Nazrax/DreamMaskV4/Lucid Scribe Data Converter/README.md

Lucid Scribe Data Converter
======================

Converts to the Lucid Scribe Data format.

<a href="http://lucid-code.com/LucidScribe/DreamMaskV4.Covnerter.zip">Download Converter</a> (Requires <a href="http://lucidcode.com/LucidScribe">Lucid Scribe</a>)

60 seconds of deep sleep: <br />

60 seconds with eye movements: <br />
