Nazrax/DreamMaskV4/eagle/combo - no usb - pth - tcrt5000.brd

## EAGLE design eagle/combo - no usb - pth - tcrt5000.brd (2014-03-25)

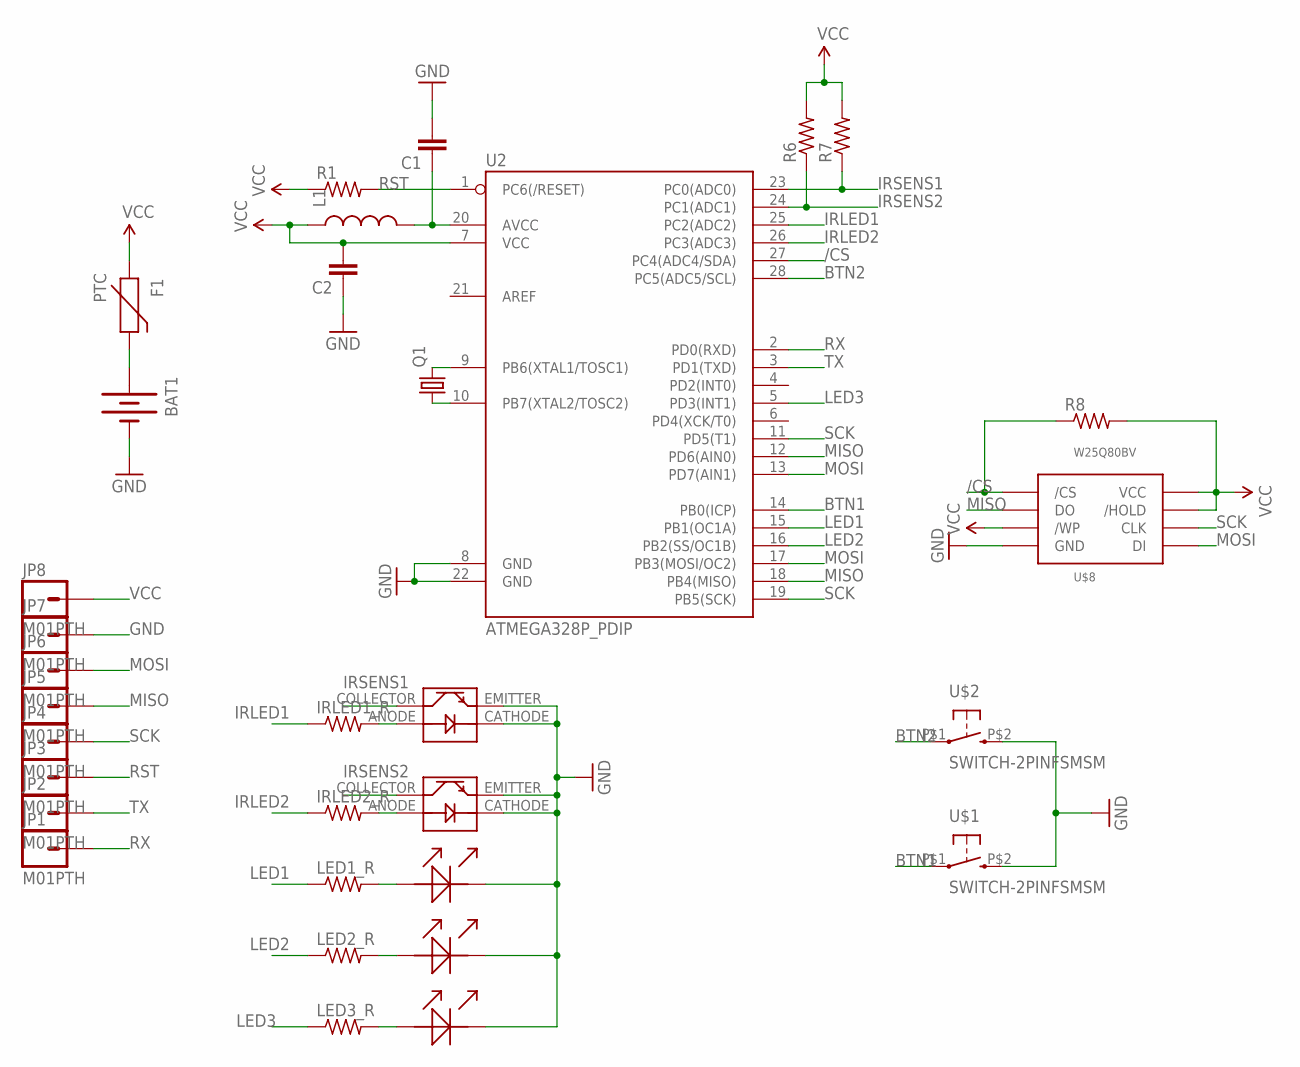
[picture p1: schematic combo - no usb - pth - tcrt5000.sch]

Parts:
BAT1: BATTERYBA2032SM; BA2032SM
C1, C2: CAP0805; 0805
F1: PTC; R0805
IRLED1_R, IRLED2_R: R-US_M0805; M0805
JP1, JP2, JP3, JP4, JP5, JP6, JP7, JP8: M01PTH; 1X01
L1: INDUCTOR0805; 0805
LED1_R, LED2_R, LED3_R: R-US_M0805; M0805
Q1: CRYSTALTC26V; TC26V
R1, R6, R7, R8: R-US_M0805; M0805
U2: ATMEGA328P_PDIP; DIL28-3
U$1, U$2: SWITCH-2PINFSMSM; FSMSM-BUTTON
U$3, U$4: IR_SENSORTCRT5000; TCRT5000
U$5, U$6: LEDPTH; LED
U$7: LED0603; 0603
U$8: W25Q80BVSOIC-08; W25Q80BV-SOIC-208MIL

Connections:
/CS: R8.1, U2.27 (PC4(ADC4/SDA)), U$8./CS
BTN1: U2.14 (PB0(ICP)), U$1.P$1 (1)
BTN2: U2.28 (PC5(ADC5/SCL)), U$2.P$1 (1)
GND: BAT1.-, C1.2, C2.1, JP7.1, U2.8 (GND), U2.22 (GND), U$1.P$2 (3), U$2.P$2 (3), U$3.CATHODE (LED-), U$3.EMITTER, U$4.CATHODE (LED-), U$4.EMITTER, U$5.-, U$6.-, U$7.2 (-), U$8.GND
IRLED1: IRLED1_R.1, U2.25 (PC2(ADC2))
IRLED2: IRLED2_R.1, U2.26 (PC3(ADC3))
IRSENS1: R7.1, U2.23 (PC0(ADC0)), U$3.COLLECTOR
IRSENS2: R6.1, U2.24 (PC1(ADC1)), U$4.COLLECTOR
LED1: LED1_R.1, U2.15 (PB1(OC1A))
LED2: LED2_R.1, U2.16 (PB2(SS/OC1B))
LED3: LED3_R.1, U2.5 (PD3(INT1))
MISO: JP5.1, U2.12 (PD6(AIN0)), U2.18 (PB4(MISO)), U$8.DO
MOSI: JP6.1, U2.13 (PD7(AIN1)), U2.17 (PB3(MOSI/OC2)), U$8.DI
unnamed: BAT1.+, F1.2
unnamed: Q1.2, U2.9 (PB6(XTAL1/TOSC1))
unnamed: Q1.1, U2.10 (PB7(XTAL2/TOSC2))
unnamed: C1.1, L1.2, U2.20 (AVCC)
unnamed: LED3_R.2, U$7.1 (+)
unnamed: LED2_R.2, U$6.+
unnamed: LED1_R.2, U$5.+
unnamed: IRLED2_R.2, U$4.ANODE (LED+)
unnamed: IRLED1_R.2, U$3.ANODE (LED+)
RST: JP3.1, R1.2, U2.1 (PC6(/RESET))
RX: JP1.1, U2.2 (PD0(RXD))
SCK: JP4.1, U2.11 (PD5(T1)), U2.19 (PB5(SCK)), U$8.CLK
TX: JP2.1, U2.3 (PD1(TXD))
VCC: C2.2, F1.1, JP8.1, L1.1, R1.1, R6.2, R7.2, R8.2, U2.7 (VCC), U$8./HOLD, U$8./WP, U$8.VCC

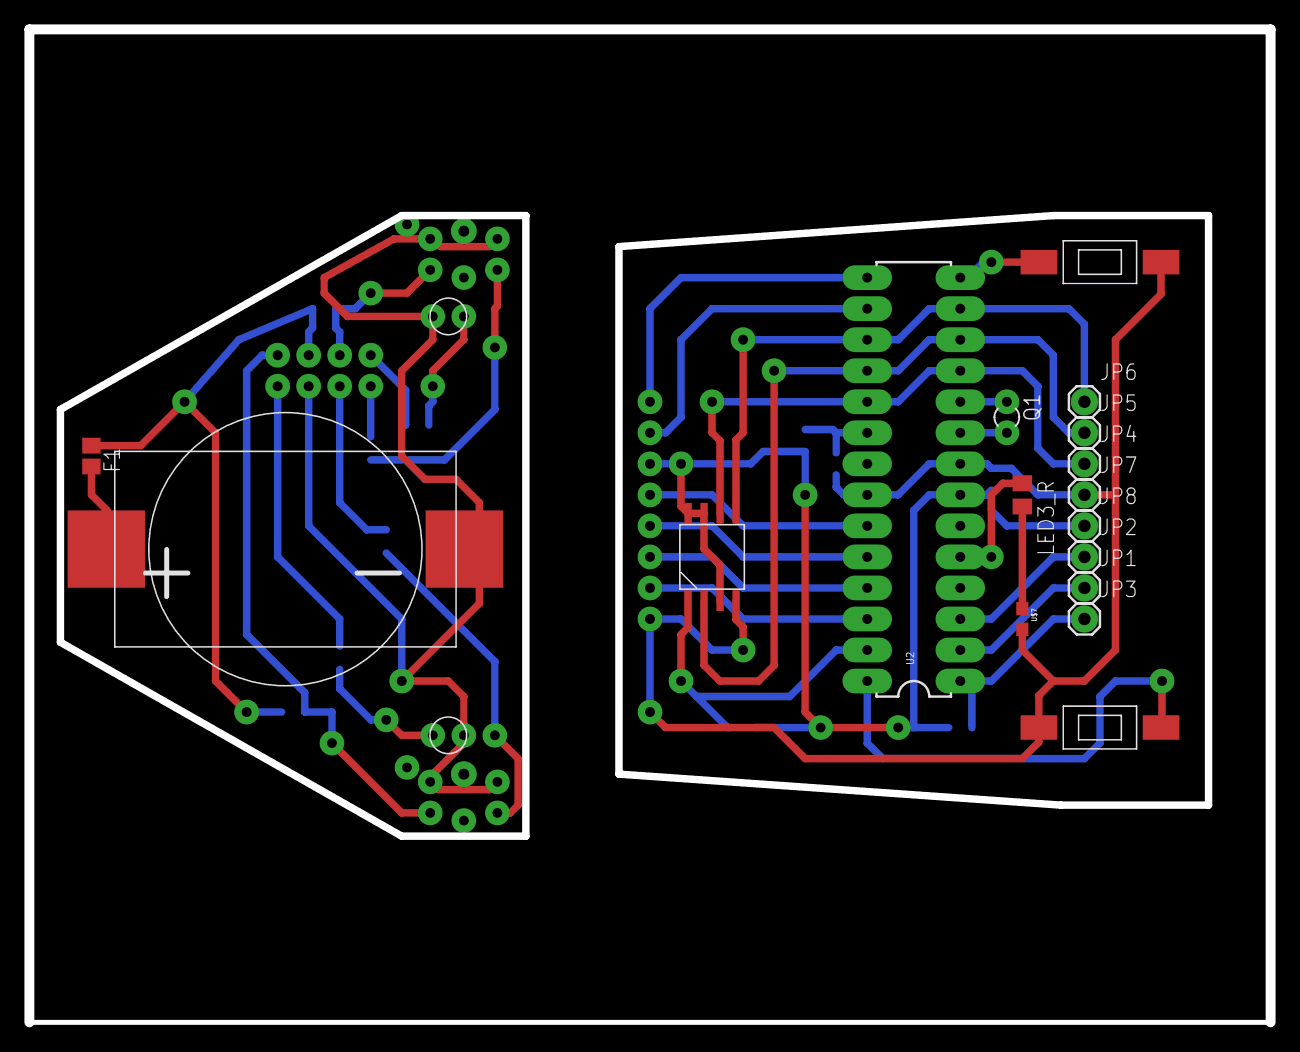
[picture p2: board combo - no usb - pth - tcrt5000.brd from above]

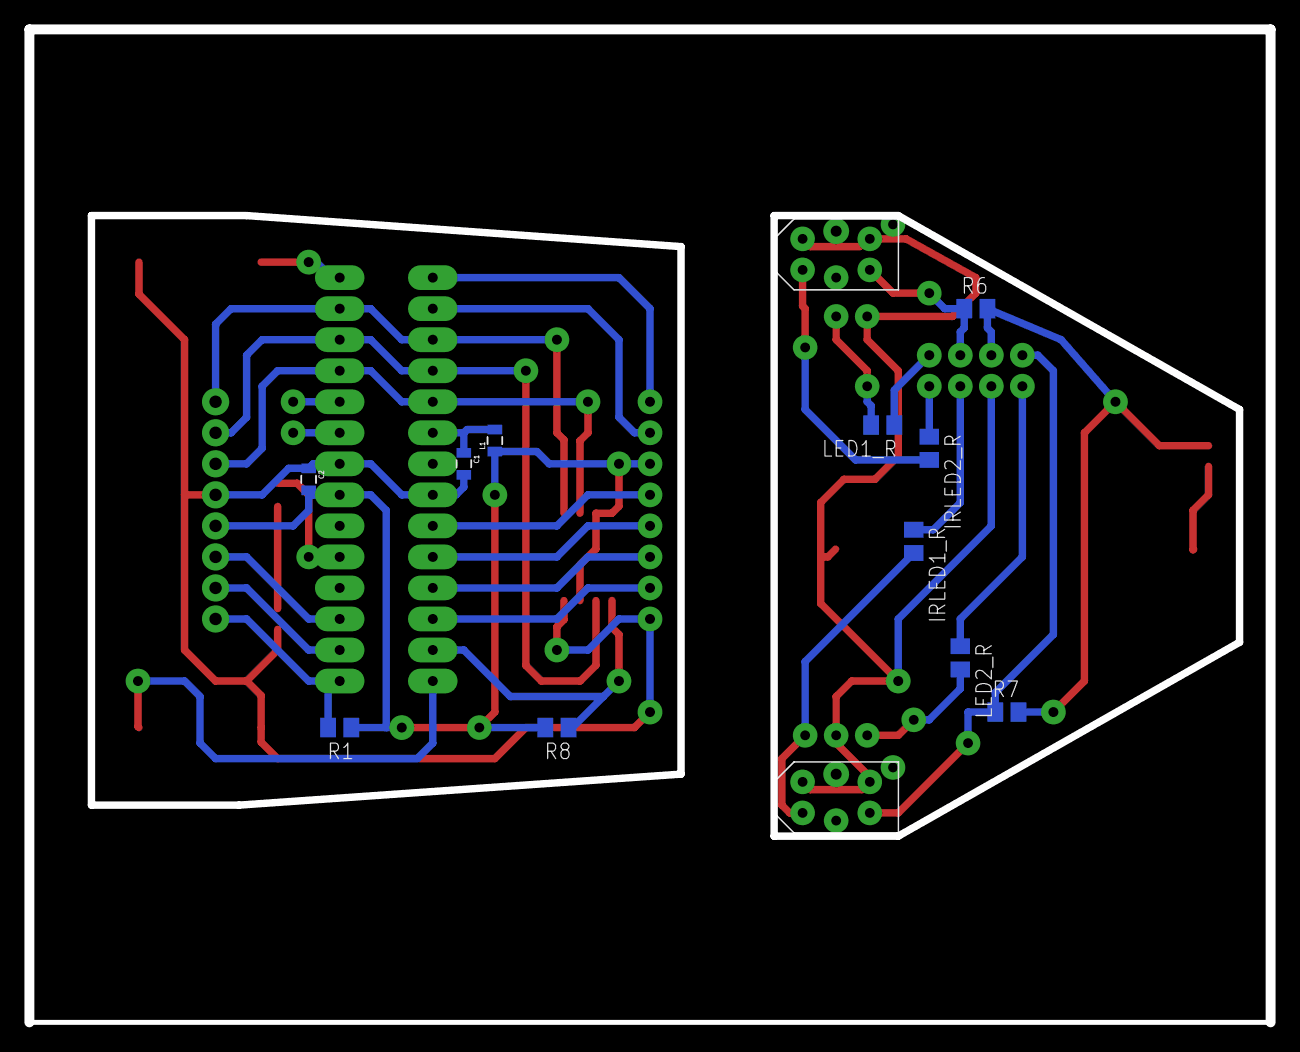
[picture p3: board combo - no usb - pth - tcrt5000.brd from below]

Board: 2 copper layers, 101.6 x 81.3 mm, 32 parts (13 on the bottom side), 27 nets.
