Nazrax/DreamMaskV4/(commit log)

2013-10-30 Initial commit - Eagle badly routed, still needs voltage dividers for sensors
    [combo - no usb - pth.brd, combo - no usb - pth.sch, combo - no usb.brd, combo - no usb.sch, combo.brd, combo.sch]
2013-10-30 Remove outdated Eagle files
    [combo - no usb.brd, combo - no usb.sch, combo.brd, combo.sch]
2013-11-04 Progress routing board
    [combo - no usb - pth.brd, combo - no usb - pth.sch]
2013-11-04 Good board design
    [combo - no usb - pth.brd]
2013-11-22 Add clock calibrator; update pin configurations
    [combo - no usb - pth - gp2s700.brd, combo - no usb - pth - gp2s700.sch]
2014-03-25 Improve LED handling code, and add LED feedback for testing
2014-03-25 Add Eagle files for the TCRT5000 sensor
    [combo - no usb - pth - tcrt5000.brd, combo - no usb - pth - tcrt5000.sch]
2014-03-25 Remove old Eagle files
    [combo - no usb - pth - gp2s700.brd, combo - no usb - pth - gp2s700.sch, combo - no usb - pth.brd, combo - no usb - pth.sch]
2014-11-21 Add initial voltage detection; add flash verification; improve ADC power usage
2014-12-11 Added optional channels with Kalman filters.
